DidacticSpark25/NTT-ASIC/(commit log)

2026-10-06 NTT accelerator for Kyber/Dilithium: model, RTL, verification, Cadence gpdk045 flow
    - Python golden model cross-checked against the pq-crystals reference C
    - Parameterized RTL: P = 1/2/4 butterflies, Barrett or Montgomery reduction,
    conflict-free XOR-banked memory, CT/GS unified butterfly with folded n^-1
    - Self-checking testbenches; 12-config regression (947,460 checks), Yosys GLS
    - Cadence flow: Xcelium, Genus, Conformal, Innovus, Tempus, Voltus, Pegasus
    - Design-space sweep and PPA collection scripts, CI workflow
    Claude-Session: https://claude.ai/code/session_01Xze52jjiQjzFnV91L2LCZV
2026-10-06 Xcelium: waveform dump + SimVision setup, run without python on lab machines
    - WAVES=1 / make waves dumps an SHM database and opens SimVision with
    control, handshake, butterfly-lane and bank signals preloaded
    - tb/vectors/ holds pre-generated test vectors (16 polys per scheme) so the
    Xcelium flow needs no python; CI checks they stay in sync with the model
    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
2026-10-13 Lab results: Kyber/Barrett/P=2 taken RTL-to-GDSII on Cadence 45 nm
    - Xcelium: 0 errors, 490 cycles/NTT as modelled
    - Genus: 13,374 cells, +7 ps @ 3.0 ns
    - Innovus: post-route setup/hold WNS +0.055/+0.060 ns, 0 DRC, 0 connectivity,
    56,648 um^2 cells in a 138,416 um^2 die, 23.8 mW, GDSII written
    - flow/lab/: the condensed Genus + Innovus scripts as actually run, plus the
    issues hit on the lab server and their fixes
    - results/lab_kyber_barrett_p2.md and layout/waveform screenshots
    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
